thalesromagna/mapping_robot/cad/robo.SLDASM

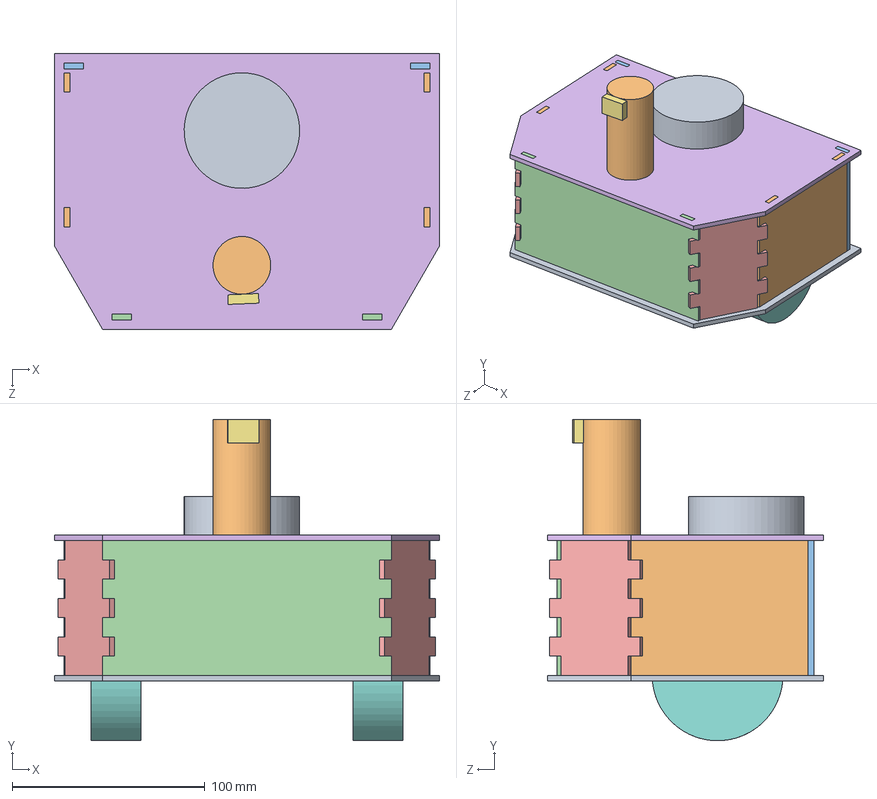
[picture p5: CAD file, 2026-10-22]
cad/robo.SLDASM
200.0 x 167.0 x 143.3 mm
base
lado10 x 2
lado20
lado14
lado5 x 2
topo
sensor
roda x 2
disco_maior
disco_menor
