thalesromagna/mapping_robot/cad/lado14.SLDPRT

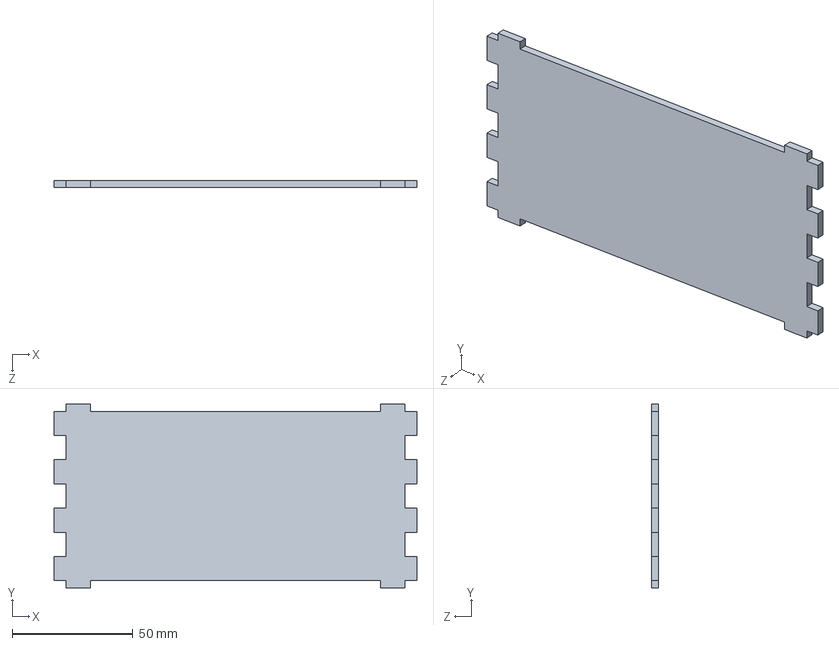
[picture p6: CAD file, 2026-10-22]
cad/lado14.SLDPRT
150.0 x 76.0 x 3.00 mm
