thalesromagna/mapping_robot/cad/lado10.SLDPRT

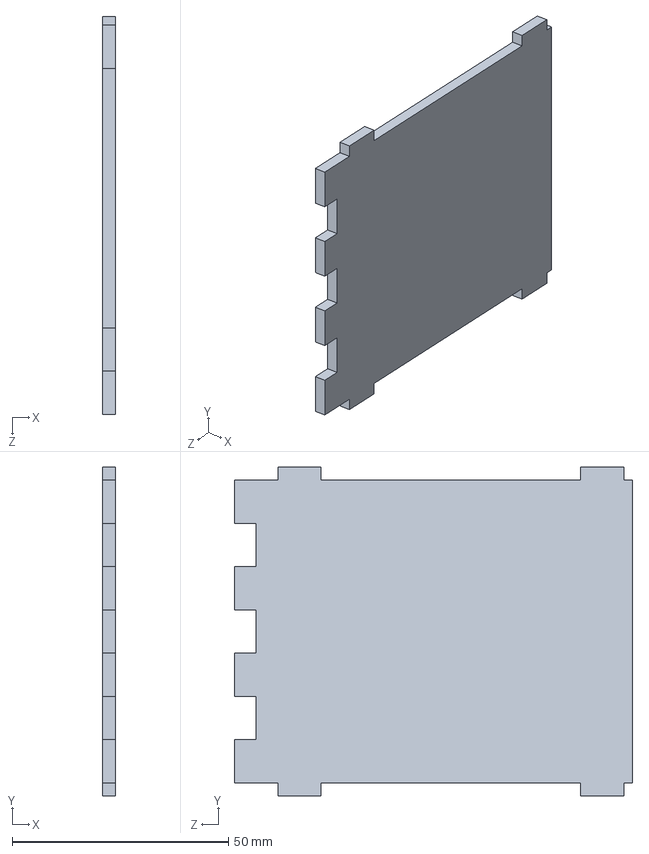
[picture p7: CAD file, 2026-10-22]
cad/lado10.SLDPRT
3.00 x 76.0 x 92.0 mm
