thalesromagna/mapping_robot/cad/base.SLDPRT

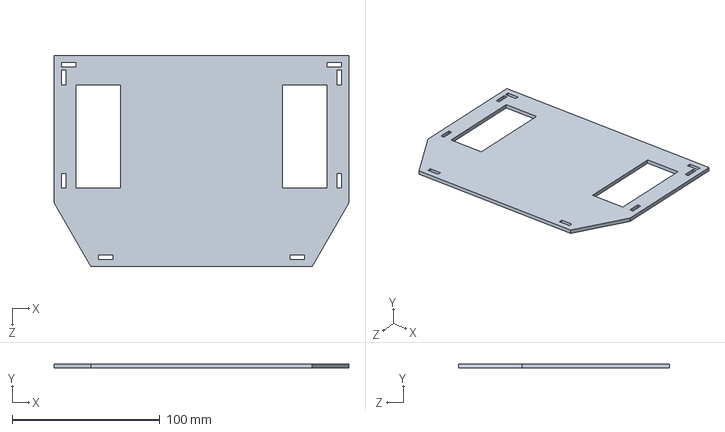
[picture p8: CAD file, 2026-10-22]
cad/base.SLDPRT
200.0 x 3.00 x 143.3 mm
