thalesromagna/mapping_robot/cad/disco_menor.SLDPRT

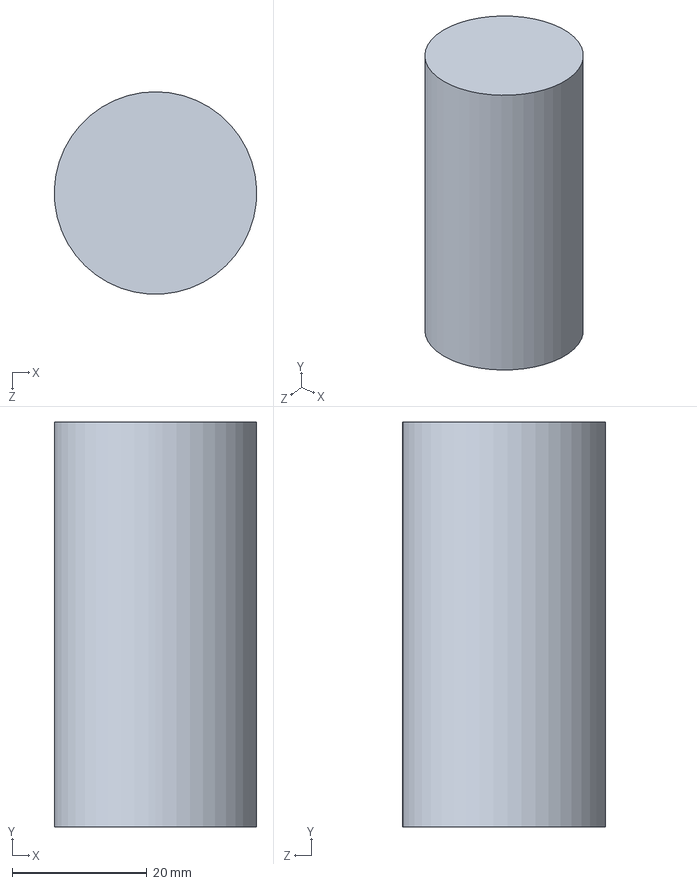
[picture p9: CAD file, 2026-10-22]
cad/disco_menor.SLDPRT
30.0 x 60.0 x 30.0 mm
