thalesromagna/mapping_robot/cad/lado20.SLDPRT

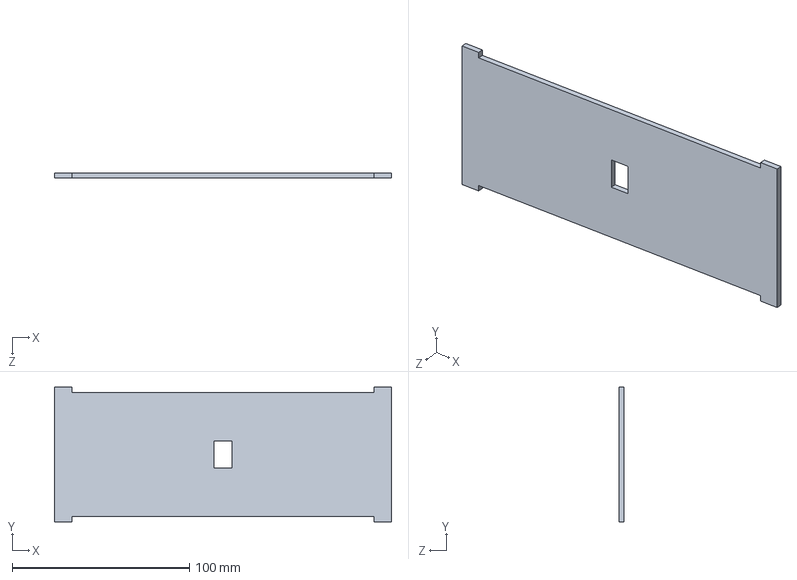
[picture p10: CAD file, 2026-10-22]
cad/lado20.SLDPRT
190.0 x 76.0 x 3.00 mm
