thalesromagna/mapping_robot/cad/disco_maior.SLDPRT

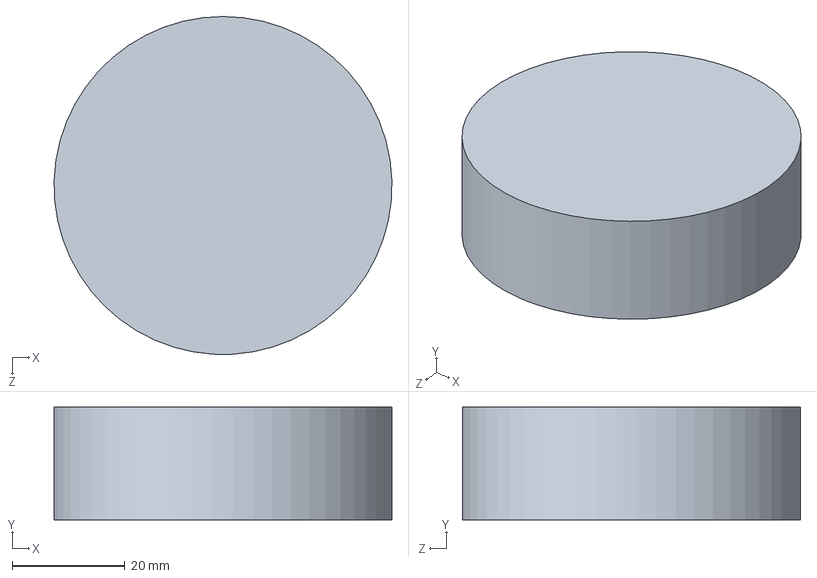
[picture p11: CAD file, 2026-10-22]
cad/disco_maior.SLDPRT
60.0 x 20.0 x 60.0 mm
