thalesromagna/mapping_robot/cad/sensor.SLDPRT

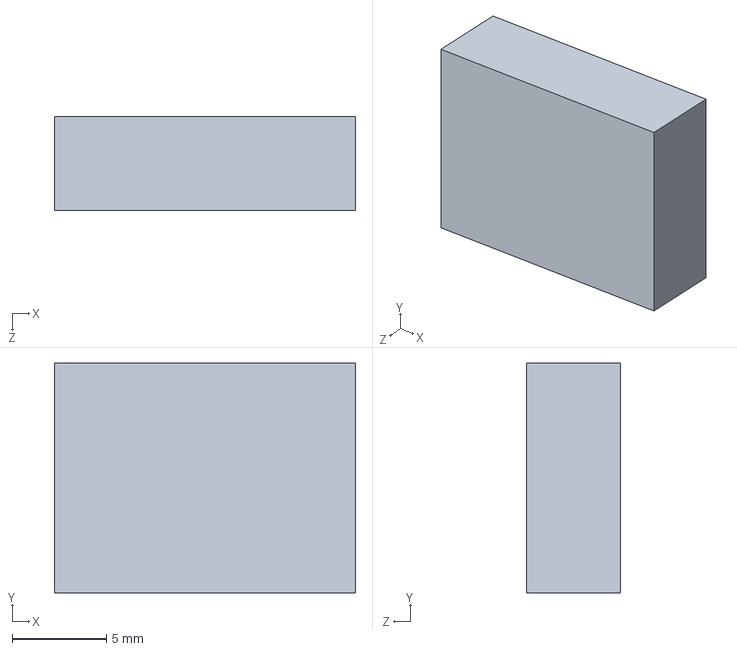
[picture p12: CAD file, 2026-10-22]
cad/sensor.SLDPRT
16.0 x 12.2 x 5.00 mm
