thalesromagna/mapping_robot/cad/lado5.SLDPRT

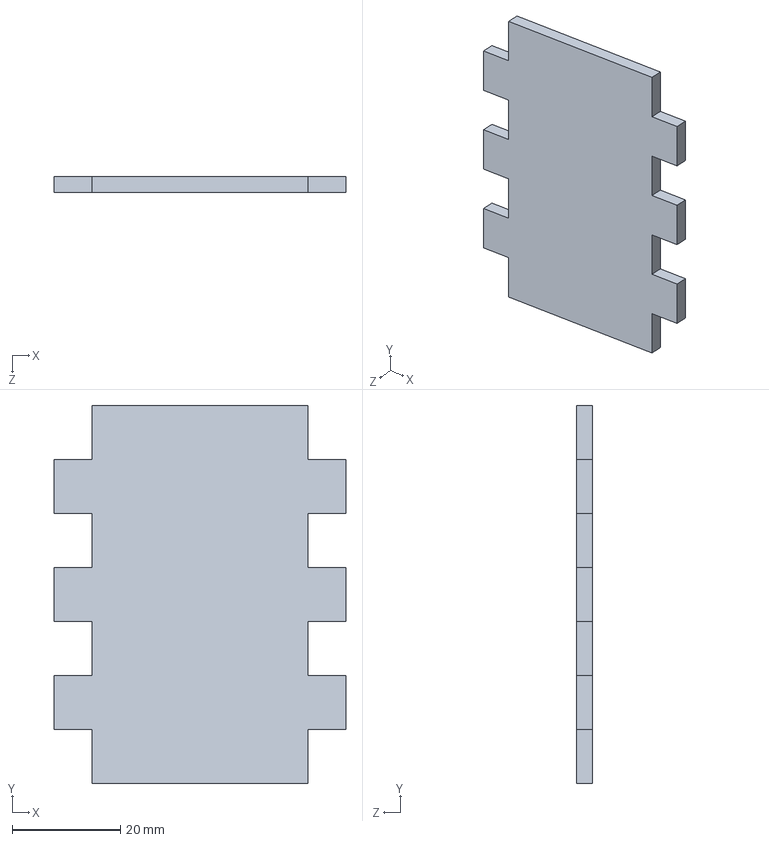
[picture p13: CAD file, 2026-10-22]
cad/lado5.SLDPRT
54.0 x 70.0 x 3.00 mm
