thalesromagna/mapping_robot/cad/roda.SLDPRT

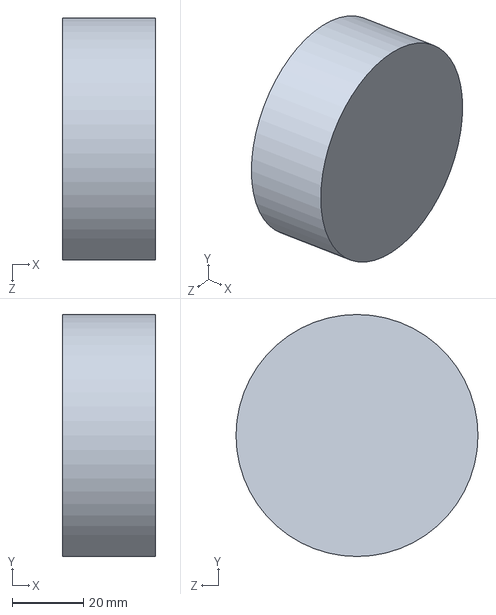
[picture p14: CAD file, 2026-10-22]
cad/roda.SLDPRT
26.0 x 68.0 x 68.0 mm
