thalesromagna/mapping_robot/cad/topo.SLDPRT

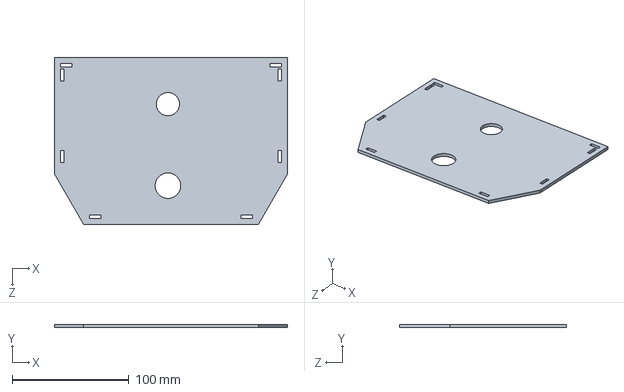
[picture p15: CAD file, 2026-10-22]
cad/topo.SLDPRT
200.0 x 3.00 x 143.3 mm
